TheColonelYoung/Hephaestus/README.md

# Hephaestus
Solder paste dispensor powered by stepper motor.
