TheColonelYoung/Hephaestus/pcb/Hephaestus.kicad_pcb

## KiCad design pcb/Hephaestus.kicad_pcb (2021-02-02)

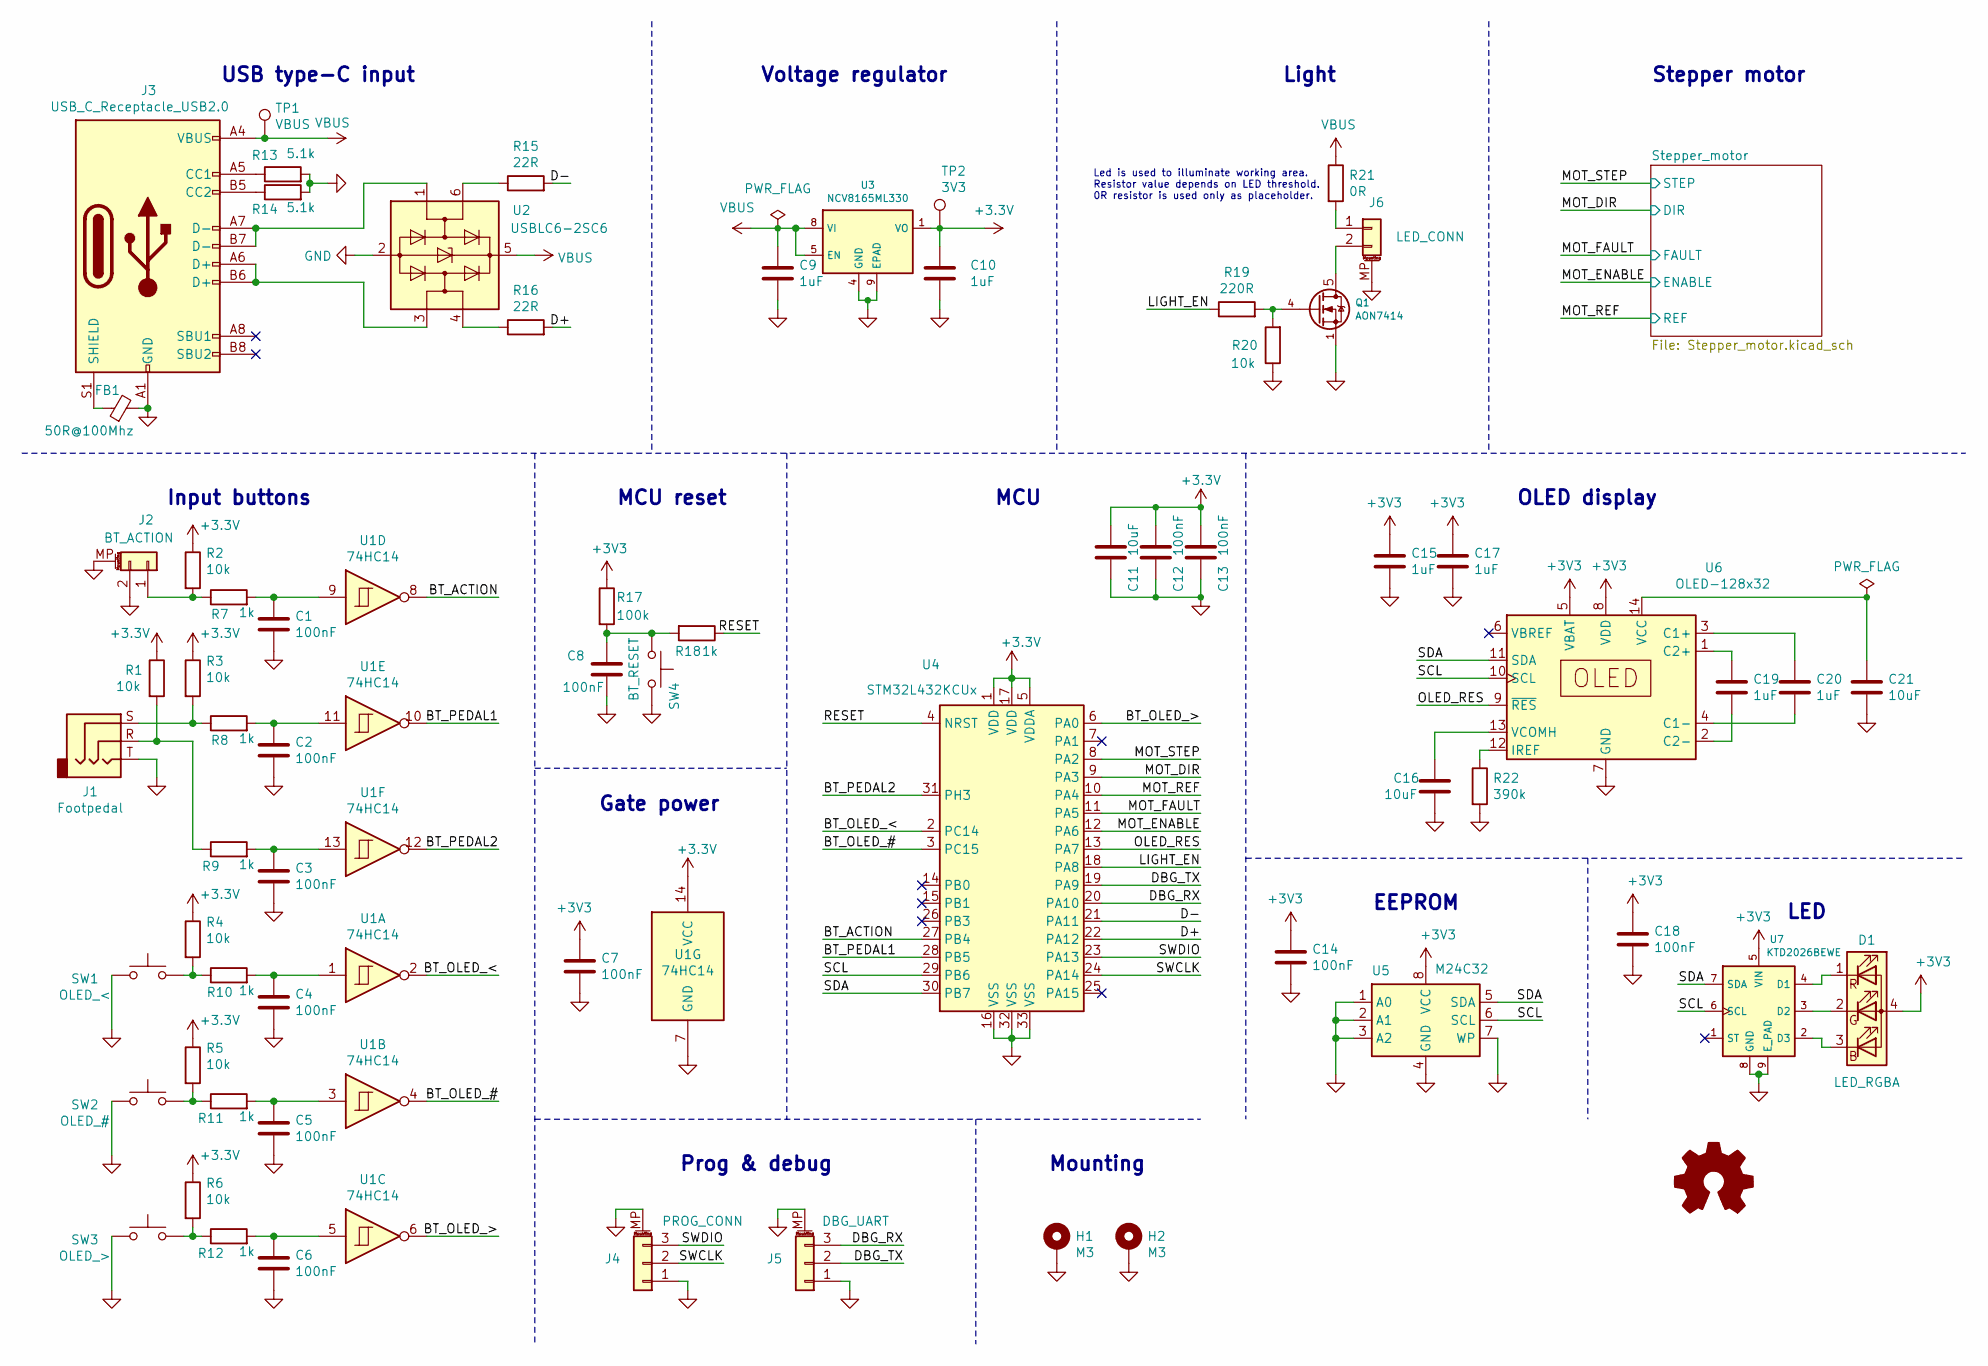
[picture p1: schematic Hephaestus.kicad_sch, Hepheatus - Solder paste dispensor]

Parts:
C1, C2, C3, C4, C5, C6, C7, C8, C12, C13, C14, C18: 100nF; C_0603_1608Metric
C9, C10, C15, C17, C19, C20: 1uF; C_0603_1608Metric
C11, C16, C21: 10uF; C_0805_2012Metric
D1: LED_RGBA; R_Array_Convex_2x0606
FB1: 50R@100Mhz; L_1206_3216Metric
H1, H2: M3; MountingHole_3.2mm_M3_Pad_Via
J1: Footpedal; Jack_3.5mm_CUI_SJ-3523-SMT_Horizontal
J2: BT_ACTION; Amphenol_10114830-11102LF_1x02_P1.25mm_Horizontal
J3: USB_C_Receptacle_USB2.0; USB_C_Receptacle_HRO_TYPE-C-31-M-12
J4: PROG_CONN; Amphenol_10114828-11103LF_1x03_P1.25mm_Vertical
J5: DBG_UART; Amphenol_10114828-11103LF_1x03_P1.25mm_Vertical
J6: LED_CONN; Amphenol_10114830-11102LF_1x02_P1.25mm_Horizontal
Q1: AON7414; DFN-8-1EP_3x3mm_P0.65mm_EP1.55x2.4mm
R1, R2, R3, R4, R5, R6, R20: 10k; R_0603_1608Metric
R7, R8, R9, R10, R11, R12, R18: 1k; R_0603_1608Metric
R13, R14: 5.1k; R_0603_1608Metric
R15, R16: 22R; R_0603_1608Metric
R17: 100k; R_0603_1608Metric
R19: 220R; R_0603_1608Metric
R21: 0R; R_1206_3216Metric
R22: 390k; R_0603_1608Metric
SW1: OLED_<; SW_SPST_TL3305A
SW2: OLED_#; SW_SPST_TL3305A
SW3: OLED_>; SW_SPST_TL3305A
SW4: BT_RESET; KMT031NGJLHS
TP1: VBUS; TestPoint_Pad_D0.5mm
TP2: 3V3; TestPoint_Pad_D0.5mm
U1: 74HC14; Texas_S-PVQFN-N14
U2: USBLC6-2SC6; SOT-23-6
U3: NCV8165ML330; DFN-8-1EP_3x3mm_P0.65mm_EP1.55x2.4mm
U4: STM32L432KCUx; QFN-32-1EP_5x5mm_P0.5mm_EP3.45x3.45mm
U5: M24C32; DFN-8-1EP_3x2mm_P0.5mm_EP1.3x1.5mm
U6: OLED-128x32; OLED_128x32
U7: KTD2026BEWE; UTDFN-8-1EP_1.5x1.5mm_P0.4mm_EP0.8x1.45mm

Connections:
/BT_ACTION: U1.8, U4.27 (PB4)
/BT_OLED_#: U1.4, U4.3 (PC15)
/BT_OLED_<: U1.2, U4.2 (PC14)
/BT_OLED_>: U1.6, U4.6 (PA0)
/BT_PEDAL1: U1.10, U4.28 (PB5)
/BT_PEDAL2: U1.12, U4.31 (PH3)
/D+: R16.2, U4.22 (PA12)
/D-: R15.2, U4.21 (PA11)
/DBG_RX: J5.3, U4.20 (PA10)
/DBG_TX: J5.2, U4.19 (PA9)
/LIGHT_EN: R19.1, U4.18 (PA8)
/MOT_DIR: U4.9 (PA3); also elsewhere on the board
/MOT_ENABLE: U4.12 (PA6); also elsewhere on the board
/MOT_FAULT: U4.11 (PA5); also elsewhere on the board
/MOT_REF: U4.10 (PA4); also elsewhere on the board
/MOT_STEP: U4.8 (PA2); also elsewhere on the board
/OLED_RES: U4.13 (PA7), U6.9 (~RES)
/RESET: R18.1, U4.4 (NRST)
/SCL: U4.29 (PB6), U5.6 (SCL), U6.10 (SCL), U7.6 (SCL)
/SDA: U4.30 (PB7), U5.5 (SDA), U6.11 (SDA), U7.7 (SDA)
/SWCLK: J4.2, U4.24 (PA14)
/SWDIO: J4.3, U4.23 (PA13)
GND: C1.2, C2.2, C3.2, C4.2, C5.2, C6.2, C7.2, C8.2, C9.2, C10.2, C11.2, C12.2, C13.2, C14.2, C15.2, C16.2, C17.2, C18.2, C21.2, FB1.2, H1.1, H2.1, J1.T, J2.2, J2.MP (MountPin), J3.A1 (GND), J3.A12 (GND), J3.B1 (GND), J3.B12 (GND), J4.1, J4.MP (MountPin), J5.1, J5.MP (MountPin), J6.MP (MountPin), Q1.1 (S), Q1.2 (S), Q1.3 (S), R13.2, R14.2, R20.1, R22.2, SW1.1, SW2.1, SW3.1, SW4.2, U1.7 (GND), U2.2 (GND), U3.4 (GND), U3.9 (EPAD), U4.16 (VSS), U4.32 (VSS), U4.33 (VSS), U5.1 (A0), U5.2 (A1), U5.3 (A2), U5.4 (GND), U5.7 (WP), U6.7 (GND), U7.8 (GND), U7.9 (E_PAD); also elsewhere on the board
unnamed: C1.1, R7.2, U1.9
unnamed: C2.1, R8.2, U1.11
unnamed: C3.1, R9.2, U1.13
unnamed: C4.1, R10.2, U1.1
unnamed: C5.1, R11.2, U1.3
unnamed: C6.1, R12.2, U1.5
unnamed: C8.1, R17.2, R18.2, SW4.1
unnamed: C16.1, U6.13 (VCOMH)
unnamed: C19.1, U6.1 (C2+)
unnamed: C19.2, U6.2 (C2-)
unnamed: C20.1, U6.3 (C1+)
unnamed: C20.2, U6.4 (C1-)
unnamed: C21.1, U6.14 (VCC)
unnamed: D1.1 (RK), U7.4 (D1)
unnamed: D1.2 (GK), U7.3 (D2)
unnamed: D1.3 (BK), U7.2 (D3)
unnamed: FB1.1, J3.S1 (SHIELD)
unnamed: J1.R, R1.2, R9.1
unnamed: J1.S, R3.2, R8.1
unnamed: J3.A5 (CC1), R13.1
unnamed: J3.A6 (D+), J3.B6 (D+), U2.3 (I/O2)
unnamed: J3.A7 (D-), J3.B7 (D-), U2.1 (I/O1)
unnamed: J3.B5 (CC2), R14.1
unnamed: J6.1, R21.2
unnamed: J6.2, Q1.5 (D), Q1.6 (D), Q1.7 (D), Q1.8 (D), Q1.9 (D)
unnamed: Q1.4 (G), R19.2, R20.2
unnamed: J2.1, R2.2, R7.1
unnamed: R4.2, R10.1, SW1.2
unnamed: R5.2, R11.1, SW2.2
unnamed: R6.2, R12.1, SW3.2
unnamed: R15.1, U2.6 (I/O1)
unnamed: R16.1, U2.4 (I/O2)
unnamed: R22.1, U6.12 (IREF)
VBUS: C9.1, J3.A4 (VBUS), J3.A9 (VBUS), J3.B4 (VBUS), J3.B9 (VBUS), R21.1, TP1.1, U2.5 (VBUS), U3.5 (EN), U3.8 (VI); also elsewhere on the board
no_connect_73: J3.A8 (SBU1)
no_connect_74: J3.B8 (SBU2)
no_connect_75: U4.14 (PB0)
no_connect_76: U4.15 (PB1)
no_connect_77: U4.25 (PA15)
no_connect_78: U4.26 (PB3)
no_connect_79: U4.7 (PA1)
no_connect_80: U6.6 (VBREF)
no_connect_81: U7.1 (ST)

Notes on the sheet:
Input buttons
USB type-C input
Gate power
MCU reset
Prog & debug
Voltage regulator
MCU
Mounting
Led is used to illuminate working area. Resistor value depends on LED threshold. 0R resistor is used only as placeholder.
Light
EEPROM
OLED display
Stepper motor
LED

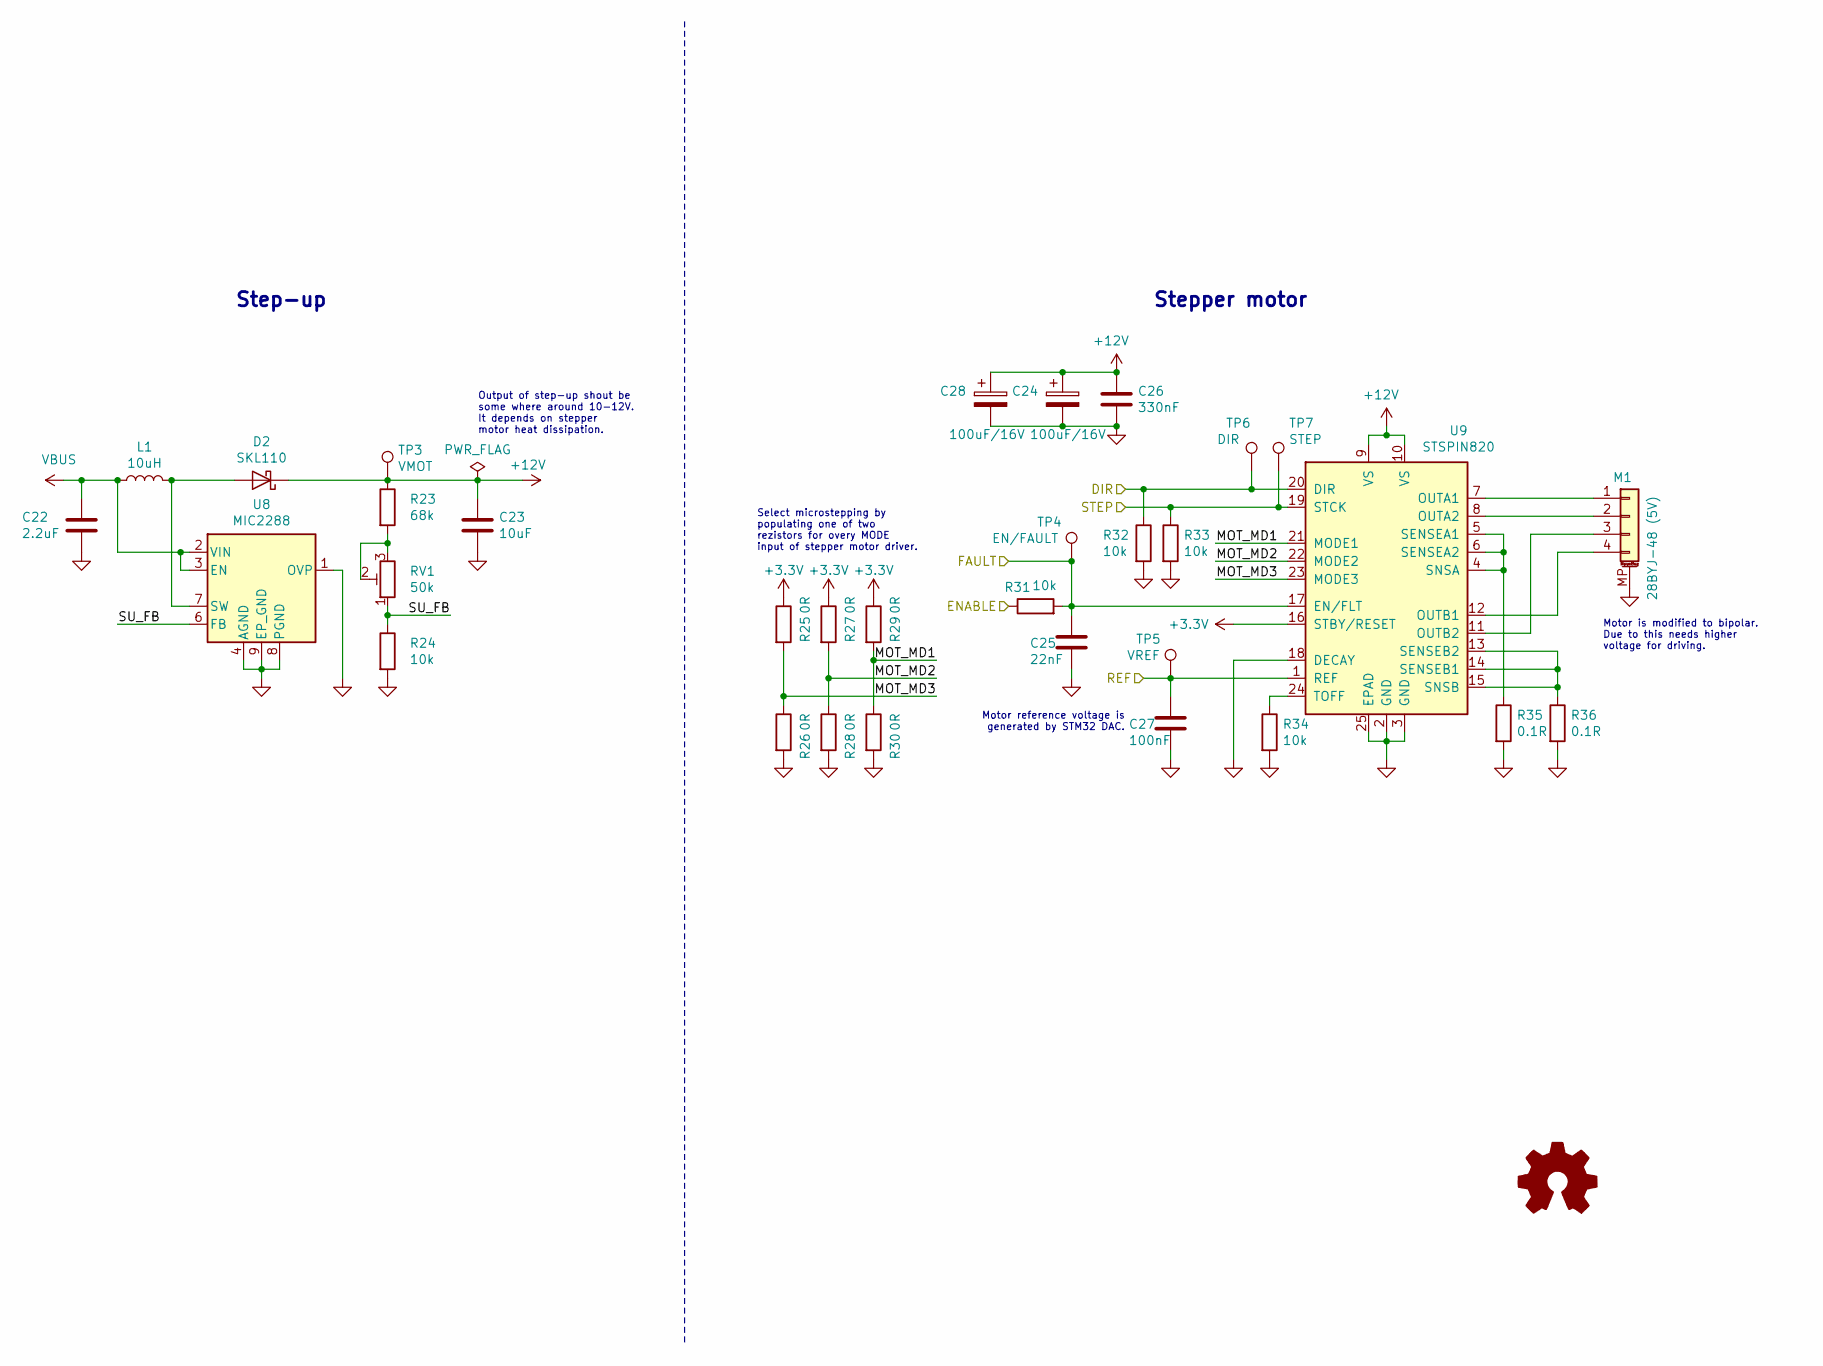
[picture p2: schematic Stepper_motor.kicad_sch, Hepheatus - Solder paste dispensor]

Parts:
C22: 2.2uF; C_0603_1608Metric
C23: 10uF; C_0805_2012Metric
C24, C28: 100uF/16V; CP_EIA-7343-30_AVX-N
C25: 22nF; C_0603_1608Metric
C26: 330nF; C_0603_1608Metric
C27: 100nF; C_0603_1608Metric
D2: SKL110; D_SOD-123F
L1: 10uH; Laird_2520
M1: 28BYJ-48 (5V); Amphenol_10114830-11103LF_1x04_P1.25mm_Horizontal
R23: 68k; R_0603_1608Metric
R24, R31, R32, R33, R34: 10k; R_0603_1608Metric
R25, R26, R27, R28, R29, R30: 0R; R_0603_1608Metric
R35, R36: 0.1R; R_1206_3216Metric
RV1: 50k; Potentiometer_Bourns_3214J_Horizontal
TP3: VMOT; TestPoint_Pad_D0.5mm
TP4: EN/FAULT; TestPoint_Pad_D0.5mm
TP5: VREF; TestPoint_Pad_D0.5mm
TP6: DIR; TestPoint_Pad_D0.5mm
TP7: STEP; TestPoint_Pad_D0.5mm
U8: MIC2288; Micrel_MLF-8-1EP_2x2mm_P0.5mm_EP0.8x1.3mm_ThermalVias
U9: STSPIN820; QFN-24-1EP_4x4mm_P0.5mm_EP2.65x2.65mm_ThermalVias

Connections:
+12V: C23.1, C24.1, C26.1, C28.1, D2.1 (K), R23.1, TP3.1, U9.9 (VS), U9.10 (VS)
/MOT_DIR: R32.1, TP6.1, U9.20 (DIR); also elsewhere on the board
/MOT_ENABLE: R31.1; also elsewhere on the board
/MOT_FAULT: C25.1, R31.2, TP4.1, U9.17 (EN/FLT); also elsewhere on the board
/MOT_REF: C27.1, TP5.1, U9.1 (REF); also elsewhere on the board
/MOT_STEP: R33.1, TP7.1, U9.19 (STCK); also elsewhere on the board
/Stepper_motor/MOT_MD1: R29.2, R30.1, U9.21 (MODE1)
/Stepper_motor/MOT_MD2: R27.2, R28.1, U9.22 (MODE2)
/Stepper_motor/MOT_MD3: R25.2, R26.1, U9.23 (MODE3)
/Stepper_motor/SU_FB: R24.1, RV1.1, U8.6 (FB)
GND: C22.2, C23.2, C24.2, C25.2, C26.2, C27.2, C28.2, M1.MP (MountPin), R24.2, R26.2, R28.2, R30.2, R32.2, R33.2, R34.2, R35.2, R36.2, U8.1 (OVP), U8.4 (AGND), U8.8 (PGND), U8.9 (EP_GND), U9.2 (GND), U9.3 (GND), U9.18 (DECAY), U9.25 (EPAD); also elsewhere on the board
unnamed: D2.2 (A), L1.2, U8.7 (SW)
unnamed: R23.2, RV1.2, RV1.3
unnamed: R34.1, U9.24 (TOFF)
unnamed: R35.1, U9.4 (SNSA), U9.5 (SENSEA1), U9.6 (SENSEA2)
unnamed: R36.1, U9.13 (SENSEB2), U9.14 (SENSEB1), U9.15 (SNSB)
unnamed: M1.1, U9.7 (OUTA1)
unnamed: M1.2, U9.8 (OUTA2)
unnamed: M1.3, U9.11 (OUTB2)
unnamed: M1.4, U9.12 (OUTB1)
VBUS: C22.1, L1.1, U8.2 (VIN), U8.3 (EN); also elsewhere on the board
no_connect_82: U8.5 (NC)

Notes on the sheet:
Step-up
Output of step-up shout be some where around 10-12V. It depends on stepper motor heat dissipation.
Select microstepping by populating one of two rezistors for overy MODE input of stepper motor driver.
Motor reference voltage is generated by STM32 DAC.
Stepper motor
Motor is modified to bipolar. Due to this needs higher voltage for driving.

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
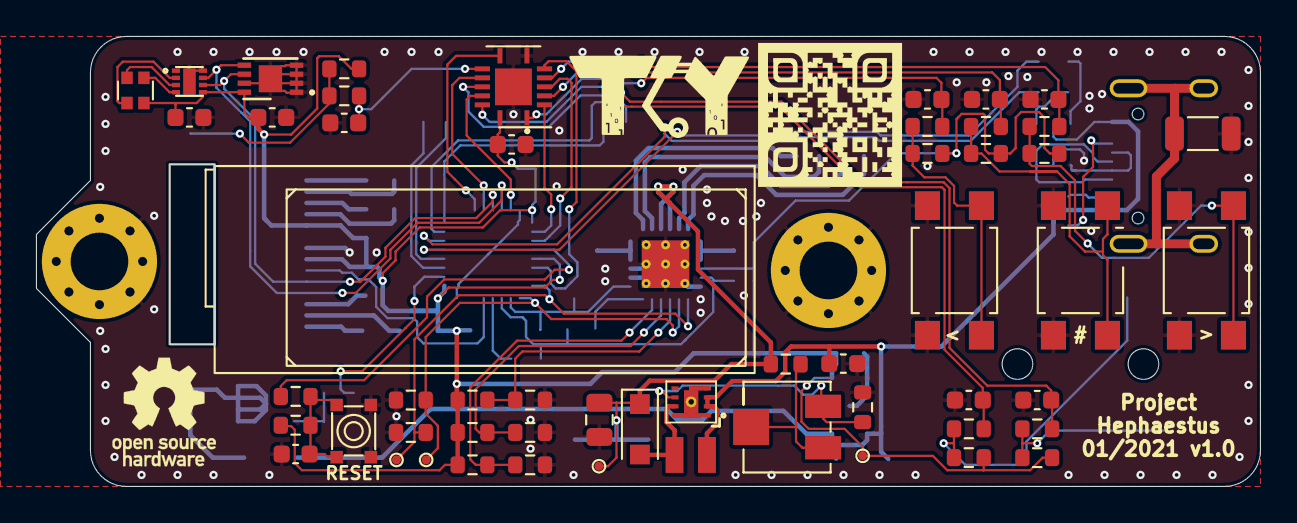
[picture p3: board Hephaestus.kicad_pcb from above]

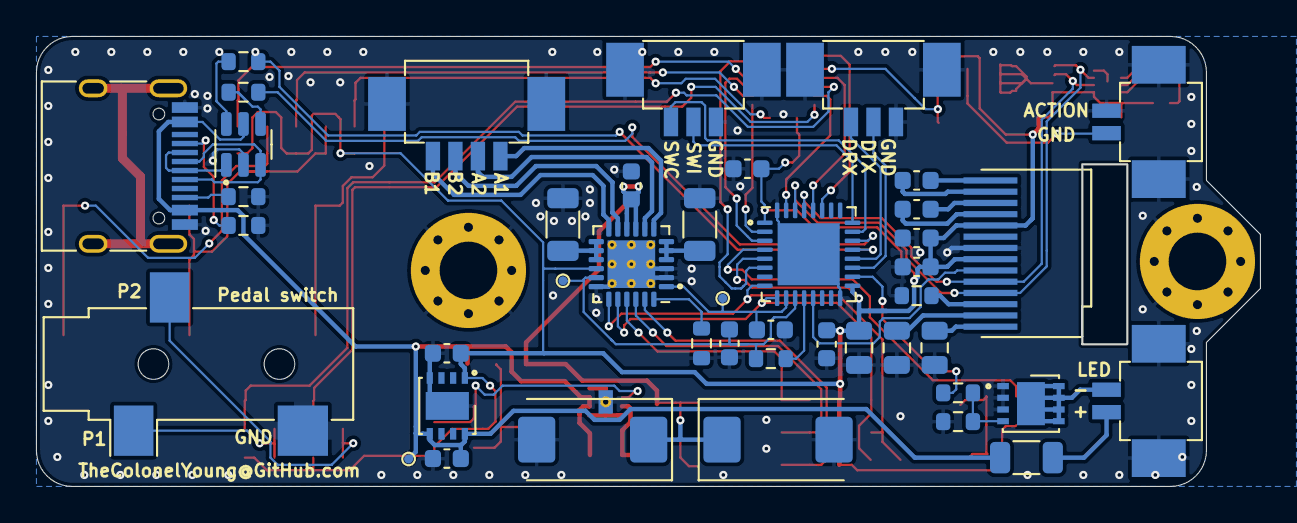
[picture p4: board Hephaestus.kicad_pcb from below]

Board: 2 copper layers, 68.0 x 25.0 mm, 99 parts (43 on the bottom side), 72 nets.
