TheColonelYoung/Hephaestus/fw/Hephaestus.ioc

Mcu.UserName=STM32L432KCUx
PA0.GPIO_Label=BT_PEDAL2
PH3-BOOT0.GPIO_Label=BT_OLED_>
PA6.GPIO_Label=MOT_FAULT
PA12.Signal=USB_DP
PB6.Signal=I2C1_SCL
PB7.Signal=I2C1_SDA
PA8.Signal=GPIO_Output
PA0.Signal=GPXTI0
PH3-BOOT0.Signal=GPXTI3
PA6.Signal=GPXTI6
PA2.GPIO_Label=MOT_STEP
PA10.Signal=USART1_RX
PB5.GPIO_Label=BT_PEDAL1
PA3.Signal=GPIO_Output
PA8.GPIO_Label=LIGHT_EN
PA9.Signal=USART1_TX
PA5.Signal=GPIO_Output
PA2.Signal=S_TIM15_CH1
PA4.Signal=COMP_DAC11_group
PB5.Signal=GPXTI5
PA7.GPIO_Label=OLED_RES
PA5.GPIO_Label=MOT_ENABLE
PA11.Signal=USB_DM
PA3.GPIO_Label=MOT_DIR
PA7.Signal=GPIO_Output
