TheColonelYoung/Hephaestus/(commit log)

2021-01-27 Schema: initial component placement
    [Hephaestus.kicad_pcb, Hephaestus.kicad_sch]
2021-01-28 Add gitignore and remove KiCAD backups
2021-01-28 Schema: add in put buttons and denoising
    [Hephaestus.kicad_sch]
2021-01-28 Schema: add light connector
    [Hephaestus.kicad_sch]
2021-01-29 Schema: change stepper motor driver to STPSIN820, add step-up convertor
    [Hephaestus.kicad_sch, Stepper_motor.kicad_sch]
2021-01-29 FW: update MCu connections to button and stepper motor
2021-01-29 Schema: connect MCU to buttons and stepper motor
    [Hephaestus.kicad_sch, Stepper_motor.kicad_sch]
2021-01-29 Schema & PCB: add page layout
2021-01-29 PCB: initial component placing and sketch board dimensions
    [Hephaestus.kicad_pcb]
2021-02-01 PCB: Basic routing done
    [Hephaestus.kicad_pcb, Hephaestus.kicad_sch, Stepper_motor.kicad_sch]
2021-02-01 FW: update MCU pin connections (Input buttons)
2021-02-02 PCB: add silkscreen marking
    [Hephaestus.kicad_pcb]
